embeddedarm/ts4100-environ-dc/README.md

# TS-4100 Environmental Monitor Daughter Card
