embeddedarm/ts4100-environ-dc/src/spi-lcd/lcd-helper/spi-lcd.c

/* SPDX-License-Identifier: BSD-2-Clause */

#include <stdio.h>
#include <stdint.h>
#include <stdlib.h>
#include <ctype.h>
#include <dirent.h>
#include <unistd.h>
#include <string.h>
#include <linux/types.h>
#include <linux/fb.h>
#include <sys/types.h>
#include <sys/stat.h>
#include <signal.h>
#include <fcntl.h>
#include <sys/mman.h>
#include <sys/ioctl.h>
#include <errno.h>
 
#include <linux/spi/spidev.h>

#define DEBUG 0

#define SPI_DEVNAME   "/dev/spidev2.1"

const char copyright[] = "Copyright (c) Technologic Systems - " __DATE__ " - "
  GITCOMMIT;

typedef enum {
   BACKLIGHT_OFF=0,
   BACKLIGHT_ON
} backlight_t;

typedef enum {
   LCD_RESETN_ACTIVE=0,
   LCD_RESETN_INACTIVE
} lcd_reset_t;

typedef enum {
   DATA_LUN=0,
   CMD_LUN
} cmdData_t;


int gotHUP;
static void sighup_handler(int signum) {
   gotHUP=1;  
	signal(signum, sighup_handler);
}

#ifndef MAX
#define MAX(x,y)  ((x)>(y)?x:y)
#endif

#define LCD_WIDTH    128
#define LCD_HEIGHT   64

static int checkHelperIsRunning(void);
static int spi_fd, lcdReset_fd, lcdCmd_fd, lcdBacklight_fd;
static unsigned char data[8][LCD_WIDTH];

static unsigned int xRes, yRes, bitsPerPixel, stride;
static volatile unsigned char*frameBuffer;
static unsigned char*previousFrameBuffer;
static unsigned long bufferSize;

static unsigned char initString[] = {   
   0xe2,    /* reset */
   0xa2,    /* LCD Bias */
   0xa0,    /* ADC Select = normal */
   0xc8,    /* Common mode = reverse (ie, top of display is row 0) */
   0xa6,    /* display normal (ie, pixel on = black) */
   0x40,    /* Start line = 0 */
   0x24, 
   0x81,    /* Electronic volume set */
   0x19, 
   0x2c, 
   0x2e, 
   0x2f,
   0xa4,    /* display all points = OFF (ie, normal) */
   0xaf,     /* display on */
};

static inline void setPixel(unsigned int x, unsigned int y) {
   
   if (x < LCD_WIDTH && y < LCD_HEIGHT)
      data[y/8][x] |= (1 << (y % 8));               
}
 
static inline void clearPixel(unsigned int x, unsigned int y) {
   
   if (x < LCD_WIDTH && y < LCD_HEIGHT)
      data[y/8][x] &= ~(1 << (y % 8));
}

static void lcd_backlight(backlight_t state)
{   
   if (state == BACKLIGHT_ON)
      write(lcdBacklight_fd, "1\n", 2);
   else
      write(lcdBacklight_fd, "0\n", 2);
}      


static void lcd_reset(lcd_reset_t state)
{
   if (state == LCD_RESETN_ACTIVE)
      write(lcdReset_fd, "0\n", 2);
   else
      write(lcdReset_fd, "1\n", 2);     
}


static void lcd_data_cmd_select(cmdData_t state)
{
   if (state == DATA_LUN) 
      write(lcdCmd_fd, "1\n", 2);
   else
      write(lcdCmd_fd, "0\n", 2);      
}

static void displayUpdateFunction(void) {

#if (DEBUG)
   int n, j;
#endif
   int i, x, y;
   unsigned char c, spi_mode, spi_bits;
   unsigned long spi_speed;
   struct spi_ioc_transfer xfer[2];
   int status;
   static unsigned char nop_cmd[1] = {0xe3};

   signal(SIGHUP, sighup_handler); // send me a SIGHUP and I'll exit!

   lcd_reset(LCD_RESETN_ACTIVE);
   usleep(50000);

	/* According to kernel 4.7.y commit 793c7f9212, it is the responsibility
	 * of the SPI device driver (not the SPI peripheral driver) to send an
	 * empty dummy transfer to prevent unwanted clock edges on first use.
	 * For some reason, the eCSPI peripheral driver seems to be ok with
	 * setting the mode after CS has been asserted. Looks like this is due
	 * to efforts for power saving. That is, when the SPI peripheral is not
	 * in active use, then there are no clocks to the SPI peripheral so
	 * there is no way to modify modes until a transaction starts which
	 * then asserts CS.
	 *
	 * Do a NOP command via SPI when the LCD is still held in reset to burn
	 * one byte and set the proper clock mode in moving forward.
	 */
	lcd_data_cmd_select(CMD_LUN);
   spi_mode = SPI_CPHA | SPI_CPOL;
   ioctl(spi_fd, SPI_IOC_WR_MODE, &spi_mode);
   spi_bits = 8;
   ioctl(spi_fd, SPI_IOC_WR_BITS_PER_WORD, &spi_bits);
   ioctl(spi_fd, SPI_IOC_RD_BITS_PER_WORD, &spi_bits);
   spi_speed = 5000000;
   ioctl(spi_fd, SPI_IOC_WR_MAX_SPEED_HZ, &spi_speed);

   memset(xfer, 0, sizeof(xfer));
   xfer[0].delay_usecs = 100;
   xfer[0].speed_hz = spi_speed;
   xfer[0].bits_per_word = spi_bits;
   xfer[0].tx_buf = (unsigned long)nop_cmd;
   xfer[0].len = sizeof(nop_cmd);
   xfer[1].rx_buf = 0;
	xfer[1].len = 0;

   if ((status = ioctl(spi_fd, SPI_IOC_MESSAGE(2), xfer)) < 0) {
      fprintf(stderr, "Error sending init string to LCD\n");
      return;
   }

   /* Now unreset LCD and send init string */
   lcd_reset(LCD_RESETN_INACTIVE);
   usleep(50000);

   memset((void*)frameBuffer, 0, bufferSize);

   *previousFrameBuffer = 1;  // to force initial lcd update


   memset(xfer, 0, sizeof(xfer));
   xfer[0].delay_usecs = 100;
   xfer[0].speed_hz = spi_speed;
   xfer[0].bits_per_word = spi_bits;
   xfer[0].tx_buf = (unsigned long)initString;
   xfer[0].len = sizeof(initString);
   xfer[1].rx_buf = 0;
	xfer[1].len = 0;

   if ((status = ioctl(spi_fd, SPI_IOC_MESSAGE(2), xfer)) < 0) {
      fprintf(stderr, "Error sending init string to LCD\n");
      return;
   }

   while(! gotHUP) {
      usleep(50000);    // approx 20Hz refresh

      if (! memcmp((void*)frameBuffer, previousFrameBuffer, bufferSize))
         continue;

      memcpy(previousFrameBuffer, (void*)frameBuffer, bufferSize);

      switch(bitsPerPixel) {
      case 1:
         {
            int bit;
            volatile unsigned char *ucp;

            for(y=0; y < yRes; y++) {
               for(x=0; x < xRes; ) {
                  unsigned long offset = (y * stride) + x/8;
                  ucp = &frameBuffer[offset];
                  for(bit=1; bit < 0x100; bit<<=1, x++) {
                     if (x >= xRes) break;
                     
                     if (*ucp & bit)
                        setPixel(x, y);
                     else
                        clearPixel(x,y);
                  }
               }
            }
         }
         break;

      default:
         printf("%d bits-per-pixel not handled yet!\n", bitsPerPixel);
         break;
      }

      for(i=0; i < 8; i++) {
         lcd_data_cmd_select(CMD_LUN);
         c = i | 0xb0;   // set page
         xfer[0].tx_buf = (unsigned long)&c;
         xfer[0].len = 1;
         ioctl(spi_fd, SPI_IOC_MESSAGE(2), xfer);
         c = 0;         // set column to zero
         ioctl(spi_fd, SPI_IOC_MESSAGE(2), xfer);
         c = 0x10;
         ioctl(spi_fd, SPI_IOC_MESSAGE(2), xfer);
         lcd_data_cmd_select(DATA_LUN);
         xfer[0].tx_buf = (unsigned long)&data[i];
         xfer[0].len = LCD_WIDTH;
         ioctl(spi_fd, SPI_IOC_MESSAGE(2), xfer);
      }
   }

   lcd_reset(LCD_RESETN_ACTIVE);
}


int main(void) {
   char name[PATH_MAX];
   int fb_fd, fd;
   DIR *dir;
   struct dirent *ent;
   struct fb_var_screeninfo screen_info;
   struct fb_fix_screeninfo fixed_info;

   if (checkHelperIsRunning()) {
      fprintf(stderr, "lcd-helper is running already\n");
      return 1;
   }

   /* Set up GPIO pins.
    * While sysfs is deprecated and will be removed fully at some point, it is
    * faster to integrate to the existing application as opposed to porting in
    * libgpiod. It also ends up being faster than used system() and gpioset
    * commands since the file handles are opened once at the start and remain
    * open for the life of the application */
   if ((fd = open("/sys/class/gpio/export",  O_WRONLY|O_SYNC)) < 0) {
      fprintf(stderr, "Can't open /sys/class/gpio/export\n");
      return 1;
   }
   write(fd, "240\n", 4); // LCD_RESET 240/5_80
   write(fd, "241\n", 4); // LCD_CMD 241/5_81
   write(fd, "238\n", 4); // Backlight 238/5_78
   close(fd);

   if ((fd = open("/sys/class/gpio/gpio240/direction",  O_RDWR|O_SYNC)) < 0) {
      fprintf(stderr, "Can't open /sys/class/gpio/gpio240/direction\n");
      return 1;
   }
   write(fd, "out\n", 4);
   close(fd);

   if ((fd = open("/sys/class/gpio/gpio241/direction",  O_RDWR|O_SYNC)) < 0) {
      fprintf(stderr, "Can't open /sys/class/gpio/gpio241/direction\n");
      return 1;
   }
   write(fd, "out\n", 4);
   close(fd);

   if ((fd = open("/sys/class/gpio/gpio238/direction",  O_RDWR|O_SYNC)) < 0) {
      fprintf(stderr, "Can't open /sys/class/gpio/gpio238/direction\n");
      return 1;
   }
   write(fd, "out\n", 4);
   close(fd);

   if ((lcdReset_fd = open("/sys/class/gpio/gpio240/value",  O_RDWR|O_SYNC)) < 0) {
   fprintf(stderr, "Can't open /sys/class/gpio/gpio240/value\n");
      return 1;
   }

   if ((lcdCmd_fd = open("/sys/class/gpio/gpio241/value",  O_RDWR|O_SYNC)) < 0) {
   fprintf(stderr, "Can't open /sys/class/gpio/gpio241/value\n");
      return 1;
   }

   if ((lcdBacklight_fd = open("/sys/class/gpio/gpio238/value",  O_RDWR|O_SYNC)) < 0) {
   fprintf(stderr, "Can't open /sys/class/gpio/gpio238/value\n");
      return 1;
   }

   if((dir = opendir("/sys/class/graphics")) == NULL) {
      fprintf(stderr, "ERROR: Cannot access /sys/class/graphics\n");
      return 1;
   }

   while((ent = readdir(dir)) != NULL) {
      snprintf(name, sizeof(name), "/dev/%s", ent->d_name);
      fb_fd = open(name, O_RDWR);
      ioctl(fb_fd, FBIOGET_FSCREENINFO, &fixed_info);
      ioctl(fb_fd, FBIOGET_VSCREENINFO, &screen_info);

      xRes = screen_info.xres;
      yRes = screen_info.yres;

      if(xRes == LCD_WIDTH && yRes == LCD_HEIGHT) break;
      close(fb_fd);
   }

   if(fb_fd > 0 && ent != NULL) {
      bitsPerPixel = screen_info.bits_per_pixel;
      stride = fixed_info.line_length;
      bufferSize = screen_info.yres_virtual *  stride;

#if (DEBUG)      
      printf("Display: %dx%dx%d stride: %d bufferSize: %d bytes\n",
         xRes, yRes, bitsPerPixel, stride, bufferSize);
#endif

      if ((previousFrameBuffer = malloc(bufferSize)) == NULL) {
         fprintf(stderr, "Memory allocation error\n");
         close(fb_fd);
         return 1;
      }

      frameBuffer = mmap(NULL, MAX(getpagesize(), bufferSize),
         PROT_READ | PROT_WRITE, MAP_SHARED | MAP_LOCKED, fb_fd, 0);
      if (frameBuffer == MAP_FAILED) {
         fprintf(stderr, "MAP_FAILED\n");
         close(fb_fd);
         exit(1);
      }

      if ((spi_fd = open(SPI_DEVNAME, O_RDWR | O_SYNC)) < 0) {
         fprintf(stderr, "Failed to open %s\n"
            "(Did you forget to modprobe spidev?)\n", SPI_DEVNAME);
         close(fb_fd);
         exit(1);
      }

      if (daemon(0,0)) {
         fprintf(stderr, "can't daemonize!\n");
         close(fb_fd);
         close(spi_fd);
         return 1;
      }

      displayUpdateFunction();
      close(fb_fd);
      close(spi_fd);

   } else {
      fprintf(stderr, "ERROR: Can't open fb device\n"
         "(Did you forget to modprobe ts-st7565p-fb?)\n");
      return 1;
   }

   return 0;
}

static int checkHelperIsRunning(void) {
	int ret;
	struct dirent entry, *ep;
	DIR *dp;
	int retVal = 0;

	if ((dp = opendir("/proc"))) {
		for (ret = readdir_r(dp, &entry, &ep); retVal == 0 && ret == 0 && ep
				!= NULL; ret = readdir_r(dp, &entry, &ep)) {
			if (ep->d_type == DT_DIR) {
				int pidDir = 1;
				char *cp = ep->d_name;

				while (*cp) {
					if (!isdigit(*cp)) {
						pidDir = 0;
						break;
					}
					cp++;
				}
				if (pidDir) {
					char buf[PATH_MAX];
					FILE *f;
					snprintf(buf, sizeof(buf), "/proc/%s/cmdline", ep->d_name);
					if ((f = fopen(buf, "r"))) {
						if (fgets(buf, sizeof(buf), f)) {
							if (strstr(buf, "lcd-helper")) {
							   if (atoi(ep->d_name) != getpid())
								retVal = 1;
							}
						}
						fclose(f);
					}
				}
			}
		}
		closedir(dp);
	}

	return retVal;
}
