embeddedarm/ts4100-environ-dc/(commit log)

2020-10-22 kicad: Initial commit of p1 files
    [ts4100-environ-station-DC.kicad_pcb, ts4100-environ-station-DC.sch]
2020-11-07 buildroot/package/ts-pixel-font: Initial commit
    Initial commit of files for a simple 4x5 pixel font for use with
    the 192x64 px monochrome LCD. This allows for much cleaner text
    display on the device.
2020-11-07 buildroot/configs/ts4100_environ: Initial commit
    Notable points:
    - Uses haveged for WPA2
    - Uses WiFi 15.3.1 drivers and firmware
    - Adds kernel config fragments and dts to support this application
2020-11-07 buildroot/board: Add default files and scripts
    This adds and installs an interfaces file. wpa_supplicant.conf
    is populated with dummy values but is made present. The
    interfaces file will try for about 1 minute to get an IP
    Also adds an init script to load WiFi and LCD modules.
    Adds startup script for env-collect.sh which loads the ZPU as
    well for OpenPIR backlight control
    Adds post-build.sh to install all of these to the right places
